pddenhar/Hardware/v0.4/Interface boards/Jeep JTEC/Manufacturing/bom jlcpcb.xlsx

Comment | Designator | Package | LCSC Part
USBLC6-2SC6 | U2 | Package_TO_SOT_SMD:SOT-23-6 | C2827654
IRF7317TRPBF | Q2 | Package_SO:SOIC-8_3.9x4.9mm_P1.27mm | C454608
RC0805JR-07360RL | R3,R4 | Resistor_SMD:R_0805_2012Metric | C245420
RC0805FR-0710KL | R1,R2,R6,R12,R13,R14,R15,R16,R17,R5,R18,R19 | Resistor_SMD:R_0805_2012Metric | C84376
NexperiaUSAInc. | D1 | Package_TO_SOT_SMD:SOT-23 | C500793
LM2903DR2G | U1 | Package_SO:SOIC-8_3.9x4.9mm_P1.27mm | C57474
SK320BTR | D2,D3,D4 | Diode_SMD:D_SMB | C65004
AO3400A | Q1 | Package_TO_SOT_SMD:SOT-23 | C20917
C0805C104K5RACTU | C4 | Capacitor_SMD:C_0805_2012Metric | C286511
RC0805FR-0710RL | R7,R8 | Resistor_SMD:R_0805_2012Metric | C96347
ERJ-6ENF1302V | R9,R11 | Resistor_SMD:R_0805_2012Metric | C17455
C2012C0G1H332J060AA | C5,C6 | Capacitor_SMD:C_0805_2012Metric | C190573
ERJP6WF1200V | R10 | Resistor_SMD:R_0805_2012Metric | C17437
