pddenhar/Hardware/v0.4/Interface boards/Jeep JTEC/Jeep JTEC.kicad_pcb

## KiCad design v0.4/Interface boards/Jeep JTEC/Jeep JTEC.kicad_pcb (2021-10-21)

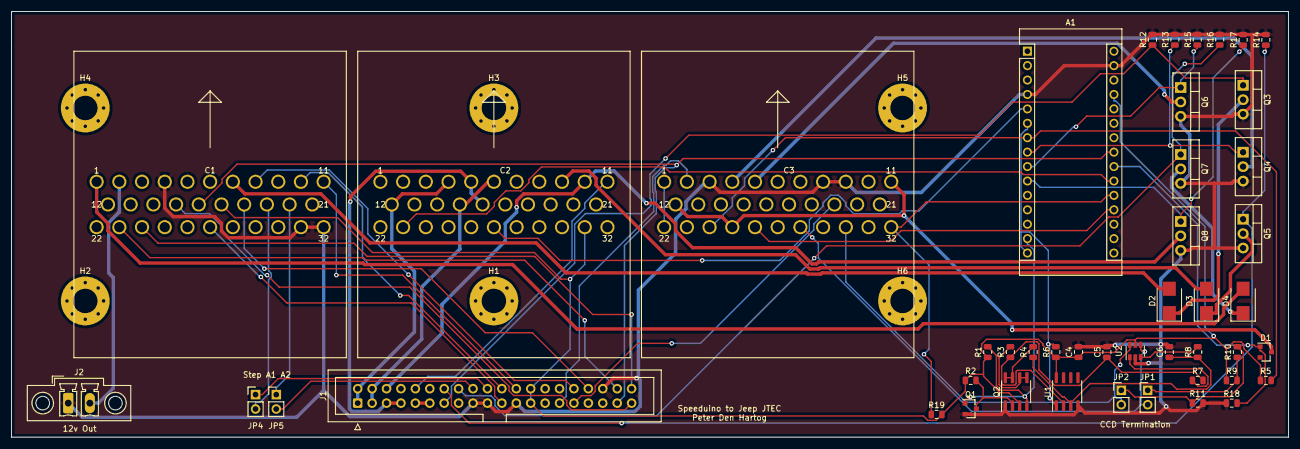
[picture p1: board Jeep JTEC.kicad_pcb from above]

Board: 2 copper layers, 225.0 x 75.0 mm, 52 parts (0 on the bottom side), 59 nets.

Parts:
A1: Arduino_Nano_v3.x; Arduino_Nano
C1, C2, C3: Conn_01x32; mopar_32pin_pcm
C4: 0.1u; C_0805_2012Metric
C5, C6: 3.3n; C_0805_2012Metric
D1: 10V; SOT-23
D2, D3, D4: D_Schottky 200v; D_SMB
H1, H2, H3, H4, H5, H6: MountingHole; MountingHole_4.3mm_M4_Pad_Via
J1: Conn_02x20_Counter_Clockwise; IDC-Header_2x20_P2.54mm_Vertical
J2: 12v SW Output; PhoenixContact_MCV_1,5_2-GF-3.81_1x02_P3.81mm_Vertical_Thre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
JP1, JP2, JP4, JP5: NO; PinHeader_1x02_P2.54mm_Vertical
Q1: AO3400; SOT-23
Q2: IRF7317; SOIC-8_3.9x4.9mm_P1.27mm
Q3, Q4, Q5, Q6, Q7, Q8: IRF540NPBF; TO-220-3_Vertical
R1, R2, R5, R6, R12, R13, R14, R15, R16, R17, R18, R19: 10k; R_0805_2012Metric
R3, R4: 360; R_0805_2012Metric
R7, R8: 10; R_0805_2012Metric
R9, R11: 13k; R_0805_2012Metric
R10: 120; R_0805_2012Metric
U1: LM2903; SOIC-8_3.9x4.9mm_P1.27mm
U2: USBLC6-2SC6; SOT-23-6

Connections:
12V-SW: C1.2, J2.2
/CCD Decoder/CCD_RX: A1.6, A1.15, R6.2, U1.1
/CCD Decoder/CCD_SAFE+: C5.1, R3.1, R7.2, U1.2
/CCD Decoder/CCD_SAFE-: C6.1, R4.1, R8.1, U1.3
/CCD Decoder/CCD_TX: A1.14, Q1.1, Q2.4, R1.2
/CCD Decoder/NOT-gate: Q1.3, Q2.2, R2.2
AC_CLUTCH_OUT: C3.1, C3.22
ASD_12V_IN: C3.11, C3.12, C3.25, D1.3
ASD_COIL_OUT: A1.4, A1.29, C1.4, C1.31, C1.32, C3.3, C3.8, C3.9, C4.2, C5.2, C6.2, J1.17, J1.19, J1.23, J1.36, J2.1, Q1.2, Q2.1, Q3.3, Q4.3, Q5.3, Q6.3, Q7.3, Q8.3, R11.2, R12.2, R13.2, R14.2, R15.2, R16.2, R17.2, R18.1, U1.4, U2.2
BRAKE_LAMP_SWITCH: A1.7, C3.24, R5.2
CAM-IN: C1.18, J1.34
CCD+: C3.30, JP2.2, U2.6
CCD-: C3.28, JP1.2, U2.4
CLT_Sensor: A1.23, C1.16, J1.37
CRANK-IN: C1.8, J1.32
CRUISE_VAC_CONTROL: A1.8, Q4.1, R13.1
CRUISE_VAC_OUT: C3.4, Q4.2
CRUISE_VENT_CONTROL: A1.9, Q6.1, R15.1
CRUISE_VENT_OUT: C3.5, Q6.2
FAN-OUT: C3.2, J1.29
FUELPUMP-OUT: C3.19, J1.31
FUEL_LEVEL: A1.19, C3.26
GENERATOR_CONTROL: A1.10, Q8.1, R17.1
GENERATOR_GND: C2.10, J1.6, Q8.2
HC-1-OUT: C2.11, J1.10
IAT_Sensor: C1.15, J1.39
IGN-1-DRIVER: C1.7, D2.2
IGN-1-OUT: J1.13, Q3.1, R12.1
IGN-2-DRIVER: C2.9, D3.2
IGN-2-OUT: J1.14, Q5.1, R14.1
IGN-3-DRIVER: C1.1, D4.2
IGN-3-OUT: J1.16, Q7.1, R16.1
INJ-1-OUT: C2.4, C2.12, J1.1, J1.2
INJ-2-OUT: C2.6, C2.15, J1.3, J1.4
INJ-3-OUT: C2.5, C2.16, J1.5, J1.7
INJ-4-OUT: J1.9, J1.11
MAP-EXT: C1.27, J1.21
unnamed: A1.22, D1.1, R18.2
unnamed: C1.19, JP4.2
unnamed: C1.20, JP5.1
unnamed: D2.1, Q3.2
unnamed: D3.1, Q5.2
unnamed: D4.1, Q7.2
unnamed: JP1.1, R9.2, R10.1
unnamed: JP2.1, R10.2, R11.1
unnamed: Q2.5, Q2.6, R3.2
unnamed: Q2.7, Q2.8, R4.2
unnamed: R7.1, U2.1
unnamed: R8.2, U2.3
O2-1-1: C1.24, J1.40
OIL_PRESSURE_IN: A1.21, C2.23
SPEED_CONTROL_SWITCH: A1.20, C3.32, R19.1
STEP-A1: J1.20, JP4.1
STEP-A2: J1.18, JP5.2
STEP-B1: C1.10, J1.22
STEP-B2: C1.11, J1.24
TPS_Sensor: C1.23, J1.38
VDDA: A1.27, C1.17, C2.31, C4.1, J1.25, J1.26, Q2.3, R1.1, R2.1, R5.1, R6.1, R9.1, R19.2, U1.8, U2.5
VSS: A1.5, C2.27
