pddenhar/Hardware/(commit log)

2021-09-28 Add draft schemtic for Jeep JTEC breakout
    [Jeep JTEC.kicad_pcb, Jeep JTEC.sch]
2021-09-29 Add pins for extension hardware
    [Jeep JTEC.sch]
2021-09-30 Start building CCD output stage
    [Jeep JTEC.sch, ccd_decoder.sch]
2021-10-04 Draw Jeep igniters and cruise control drivers
    [Jeep JTEC.sch, ccd_decoder.sch, drivers.sch]
2021-10-04 Add voltage sense circuit for alternator control
    [Jeep JTEC.sch, ccd_decoder.sch, drivers.sch]
2021-10-04 Route PCB for JTEC breakout
    [Jeep JTEC.kicad_pcb, Jeep JTEC.sch, ccd_decoder.sch, drivers.sch]
2021-10-04 Add BOM items for jellybean parts
    [Jeep JTEC.sch, ccd_decoder.sch, drivers.sch]
2021-10-06 Add jumper for GND and GNDA. Add 12v-SW output
    [Jeep JTEC.sch, ccd_decoder.sch, drivers.sch]
2021-10-07 Add 12v output to PCB
    [Jeep JTEC.kicad_pcb, Jeep JTEC.sch]
2021-10-07 Add pull up resistor to cruise control input
    [Jeep JTEC.kicad_pcb, Jeep JTEC.sch]
2021-10-07 Switch project specific symbols to use path substitution
2021-10-08 Add BOM and gerbers
    [CPL.xlsx, Jeep JTEC-B_Cu.gbr, Jeep JTEC-B_Mask.gbr, Jeep JTEC-B_Paste.gbr, Jeep JTEC-B_SilkS.gbr, Jeep JTEC-Edge_Cuts.gbr, Jeep JTEC-F_Cu.gbr, Jeep JTEC-F_Mask.gbr]
2021-10-09 Correct the footprint for U2
    [Jeep JTEC-B_Cu.gbr, Jeep JTEC-B_Mask.gbr, Jeep JTEC-B_Paste.gbr, Jeep JTEC-B_SilkS.gbr, Jeep JTEC-Edge_Cuts.gbr, Jeep JTEC-F_Cu.gbr, Jeep JTEC-F_Mask.gbr, Jeep JTEC-F_Paste.gbr]
2021-10-09 Correct stepper IAC phases
    [Jeep JTEC-B_Cu.gbr, Jeep JTEC-B_Mask.gbr, Jeep JTEC-B_Paste.gbr, Jeep JTEC-B_SilkS.gbr, Jeep JTEC-Edge_Cuts.gbr, Jeep JTEC-F_Cu.gbr, Jeep JTEC-F_Mask.gbr, Jeep JTEC-F_Paste.gbr]
2021-10-11 Add diodes to igniter circuit to allow ringing
    [BOM.xlsx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]
2021-10-21 Correct drill size for JTEC connector
    [BOM.xlsx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]
